fedecobia-bit/BBs-Counter-2.0/schematic.png

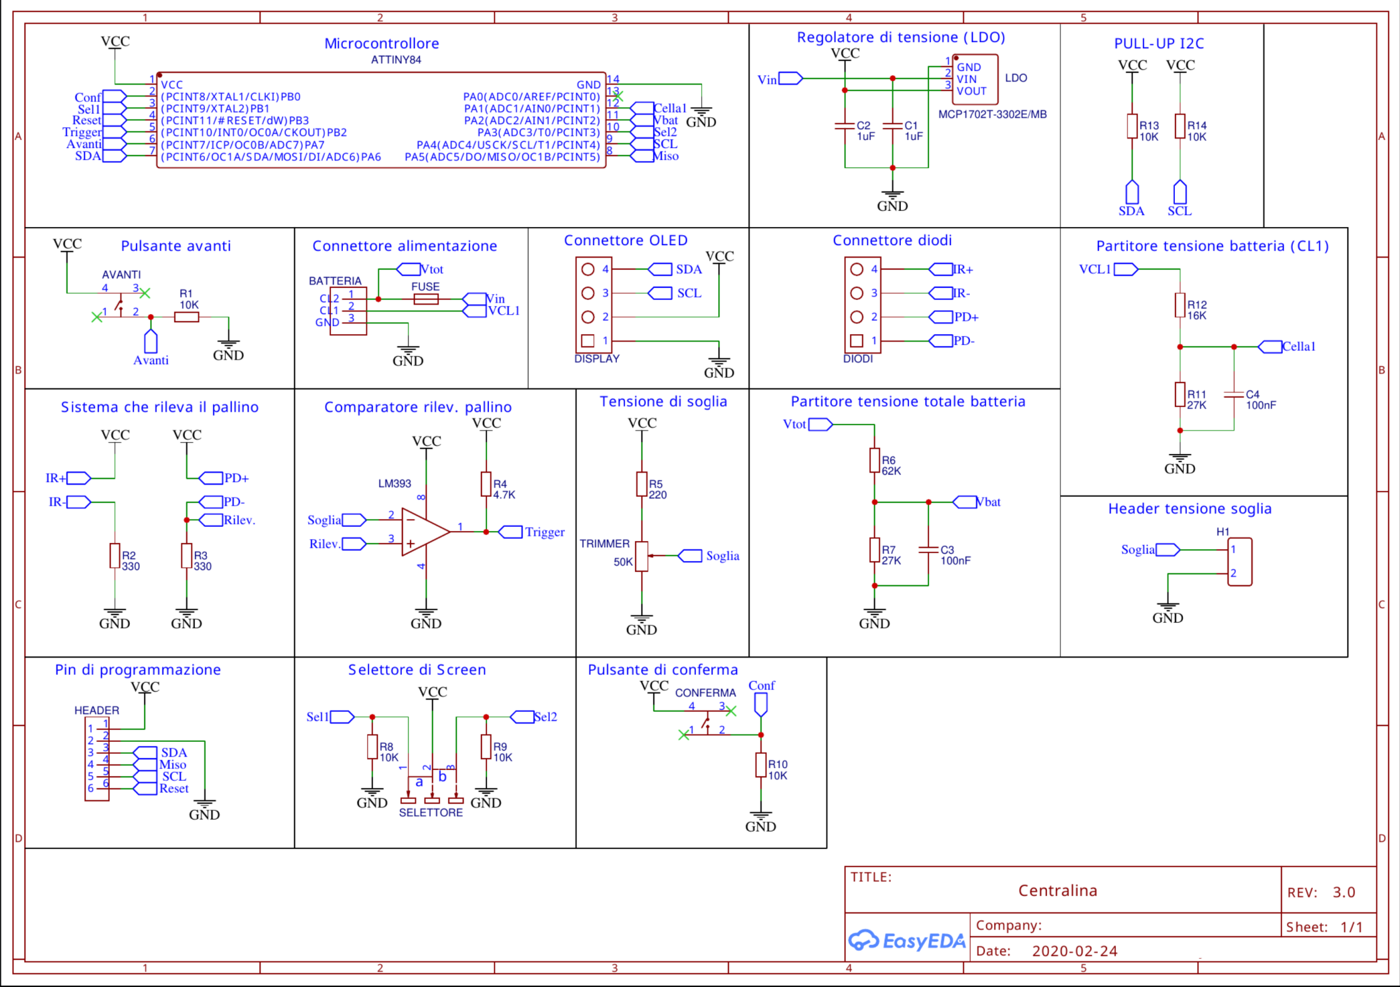
schematic.png
