fedecobia-bit/BBs-Counter-2.0/BOM.pdf

ID | Name | Designator | Footprint | Quantity | Manufacturer Part | Manufacturer | Supplier | Supplier Part
1 | 1uF | C1,C2 | C0805 | 2 | GRM21BR71E105KA99L | MuRata | LCSC | C77080
2 | 0466.500NR | FUSE | F1206 | 1 | 0466.500NR | Littelfuse | LCSC | C206988
3 | K2-6639DP-B4SW-04 | AVANTI,CONFERMA | KEY-TH_4P-L6.0-W6.0-P4.50-LS7.5 | 2 | K2-6639DP-B4SW-04 | HRO | LCSC | C83205
4 | MCP1702T-3302E/MB | LDO | SOT-89-3_L4.5-W2.5-P1.50-LS4.2-BR | 1 | MCP1702T-3302E/MB | MICROCHIP | LCSC | C88418
5 | 4.7K | R4 | R0805 | 1 | RK73B2ATTD472J | KOA | LCSC | C159919
6 | JST-XH | BATTERIA | JST-XH_3-PIN VGS | 1 | B3B-XH-A(LF)(SN) | | | 455-2248-ND
7 | ATTINY84 | ATTINY84 | SOIC-14_L8.7-W3.9-P1.27-LS6.0-BL | 1 | ATTINY84A-SSUR | Microchip Tech | LCSC | C220597
8 | Connettore OLED | DISPLAY,DIODI | JST_XH_04X2.50MM | 2 | New SchematicLib
9 | 100nF | C4,C3 | C0805 | 2 | 0805B104K250 | Huaxin S&T | LCSC | C128353
10 | 220 | R5 | R0805 | 1 | RK73H2ATTD2200F | KOA | LCSC | C160072
11 | 62K | R6 | R0805 | 1 | RK73H2ATTD1502F | KOA | LCSC | C160068
12 | 16K | R12 | R0805 | 1 | RK73H2ATTD1502F | KOA | LCSC | C160068
13 | 330 | R3,R2 | R0805 | 2 | RK73B2ATTD331J | KOA | LCSC | C159915
14 | 50K | TRIMMER | PCB_TRIM_POT_PARALELO | 1 | TRIMPOT
15 | 1x6 Header | HEADER | 1X6 HEADER | 1
16 | Header-Male-2.54_1x2 | H1 | HDR-TH_2P-P2.54-V | 1 | 826629-2 | TE Connectivity | LCSC | C86471
17 | 10K | R9,R10,R1,R13,R14,R8 | R0805 | 6 | RK73B2ATTD103J | KOA | LCSC | C159912
18 | 27K | R11,R7 | R0805 | 2 | RK73B2ATTD103J | KOA | LCSC | C159912
19 | K3-1260D-L1 | SELETTORE | SW-TH_K3-1260D-L1 | 1 | K3-1260D-L1 | HRO | LCSC | C92657
20 | LM393M | LM393 | SOP-8_L4.9-W3.9-P1.27-LS6.0-BL | 1 | LM393M/TR | HGSEMI | LCSC | C356703
