fedecobia-bit/BBs-Counter-2.0/Total Cost.pdf

Componente | Quantità | Costo unitario | Costo totale
ATTINY84 | 1 | 1,000682 € | 1,000682 €
Pulsante | 2 | 0,038200 € | 0,076400 €
JST 3pin | 1 | 0,026065 € | 0,026065 €
Cond [1uF] | 2 | 0,055840 € | 0,111680 €
Cond [100nF] | 2 | 0,014911 € | 0,029822 €
JST 4pin | 2 | 0,026065 € | 0,052130 €
Fusibile | 1 | 0,087174 € | 0,087174 €
Header 2 | 1 | 0,001884 € | 0,001884 €
Header 6 | 1 | 0,001884 € | 0,001884 €
LDO | 1 | 0,399318 € | 0,399318 €
LM393 | 1 | 0,050653 € | 0,050653 €
Res [10k] | 6 | 0,006481 € | 0,038886 €
Res [330] | 2 | 0,006134 € | 0,012268 €
Res [4,7k] | 1 | 0,004801 € | 0,004801 €
Res [62k] | 1 | 0,004851 € | 0,004851 €
Res [220] | 1 | 0,006360 € | 0,006360 €
Res [27k] | 2 | 0,004777 € | 0,009554 €
Res [16k] | 1 | 0,004351 € | 0,004351 €
Selettore | 1 | 0,130500 € | 0,130500 €
Trimmer | 1 | 0,183166 € | 0,183166 €
Display | 1 | 6,990000 € | 6,990000 €
Fotodiodo [850nm] | 1 | 0,726000 € | 0,726000 €
Diodo IR [850nm] | 1 | 0,491000 € | 0,491000 €
PCB | 1 | 0,354000 € | 0,354000 €
Spedizione 1 | 31 | 0,013826 € | 0,428606 €
Spedizione 2 | 1 | 1,592000 € | 1,592000 €
| | TOTALE | 12,814035 €

## Costo singola scheda
