fedecobia-bit/BBs-Counter-2.0/PCB.pdf

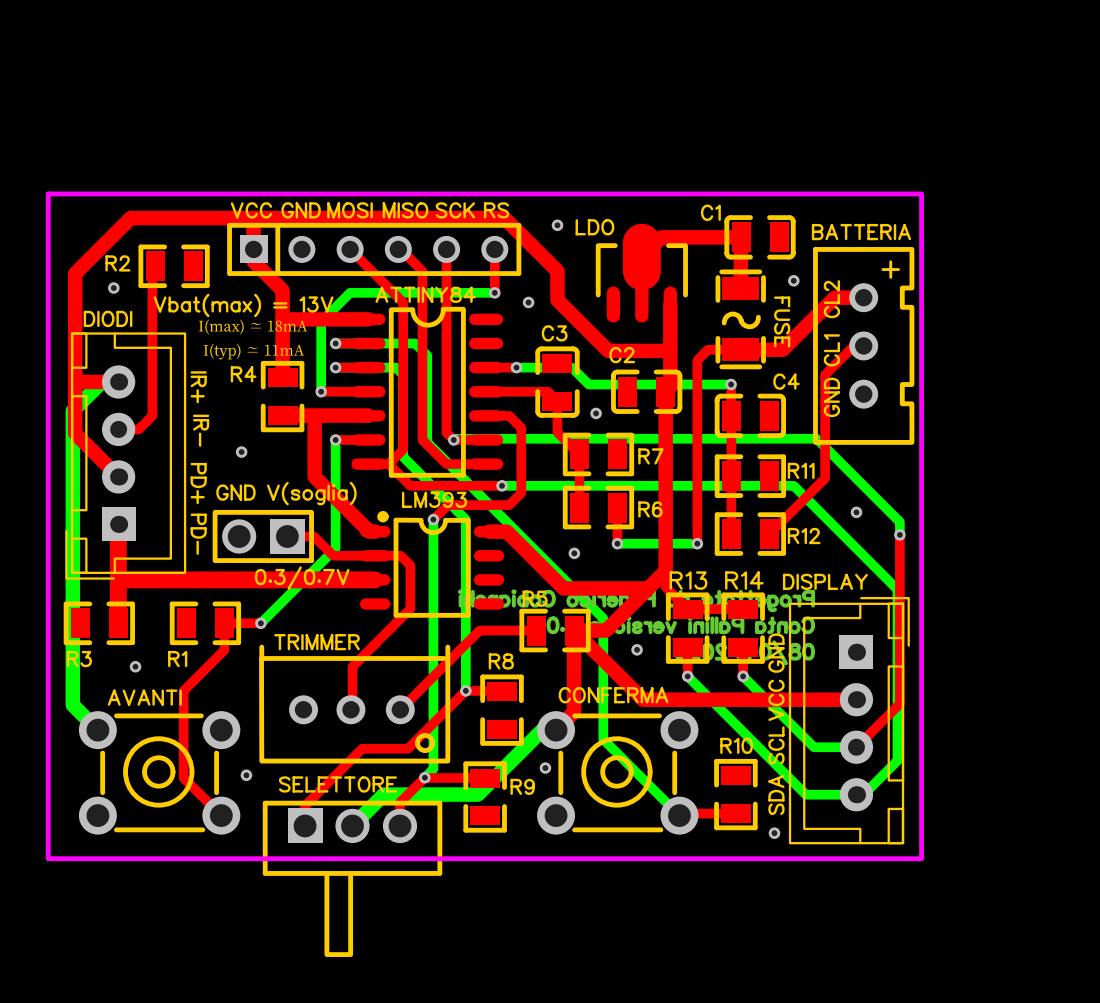
[picture p14: page 1]
